shimniok/eeZeeAmp/README.md

eeZeeAmp is a breakout board for a standard LM386 audio amplifier circuit making it convenient to add audio
amplification to your breadboard projects.
