shimniok/eeZeeAmp/electronics/eeZeeAmp.brd

## EAGLE design electronics/eeZeeAmp.brd (2015-09-28)

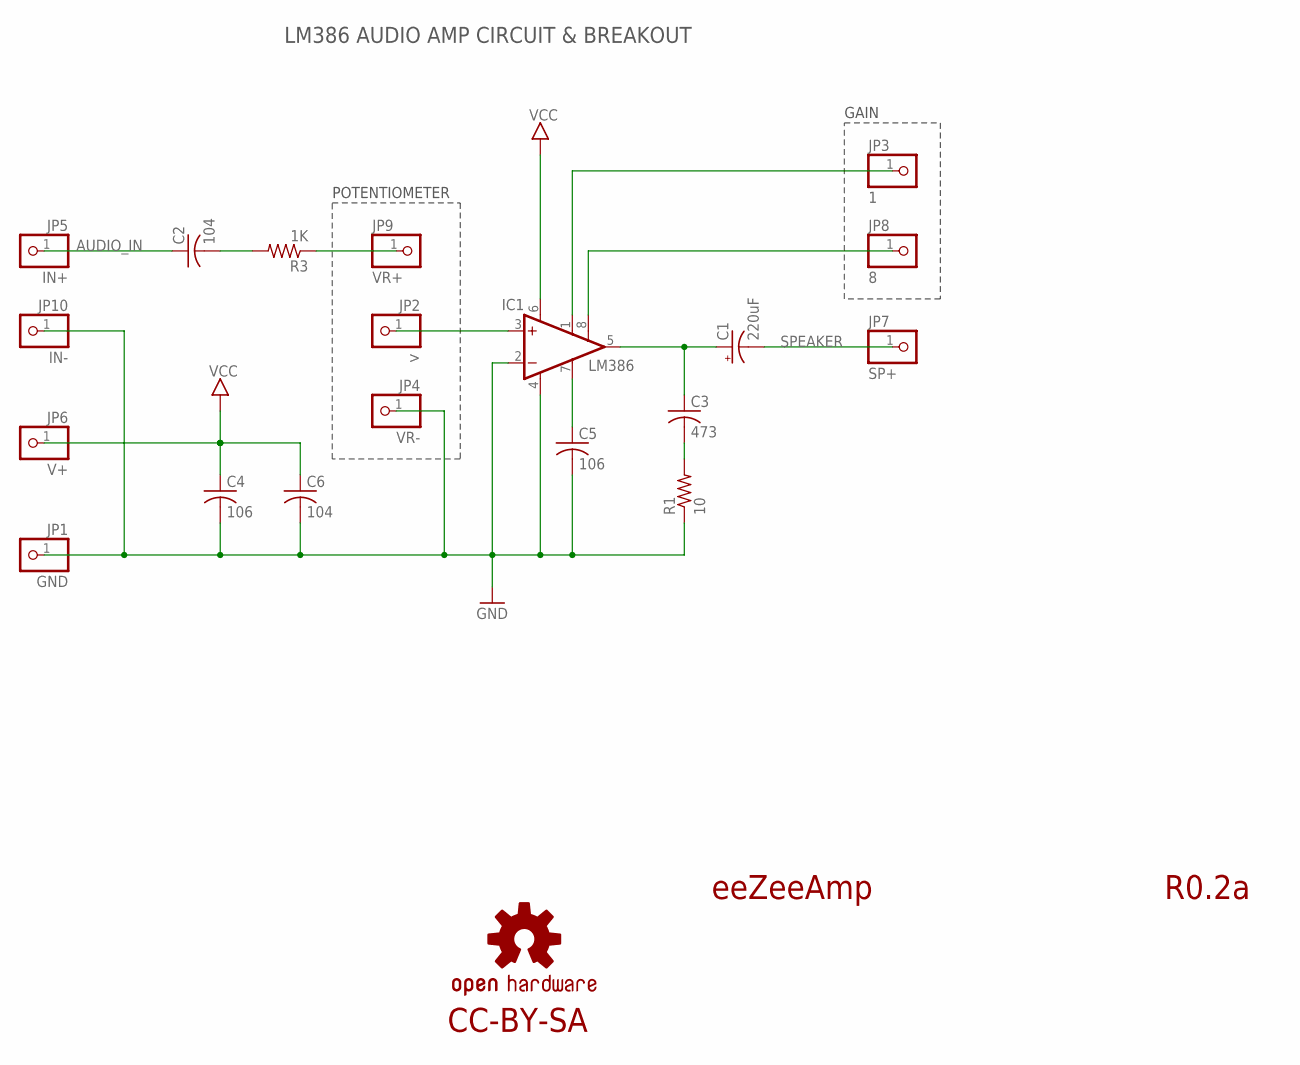
[picture p5: schematic eeZeeAmp.sch]

Parts:
C1: 220uF; E3,5-8
C2, C6: 104; C0603
C3: 473; C0603
C4, C5: 106; C1206
IC1: LM386; SO08
JP1: GND; 1X01-S
JP2: >; 1X01-S
JP3: 1; 1X01-S
JP4: VR-; 1X01-S
JP5: IN+; 1X01-S
JP6: V+; 1X01-S
JP7: SP+; 1X01-S
JP8: 8; 1X01-S
JP9: VR+; 1X01-S
JP10: IN-; 1X01-S
LOGO2: OSHW-LOGOS; OSHW-LOGO-S
R1: 10; R0603
R3: 1K; R0603

Connections:
1: IC1.1 (GAIN), JP3.1
3: IC1.3 (+IN), JP2.1
5: C1.+, C3.1, IC1.5 (OUT)
7: C5.1, IC1.7 (BYPASS)
8: IC1.8 (GAIN), JP8.1
AUDIO_IN: C2.1, JP5.1
GND: C4.2, C5.2, C6.2, IC1.2 (-IN), IC1.4 (GND), JP1.1, JP4.1, JP10.1, R1.1
unnamed: C2.2, R3.2
unnamed: C3.2, R1.2
unnamed: JP9.1, R3.1
SPEAKER: C1.-, JP7.1
VCC: C4.1, C6.1, IC1.6 (VS), JP6.1

Notes on the sheet:
eeZeeAmp
R0.2a
POTENTIOMETER
LM386 AUDIO AMP CIRCUIT & BREAKOUT
GAIN
CC-BY-SA

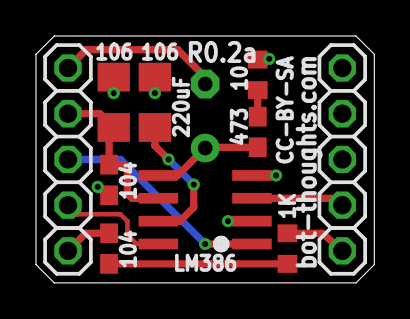
[picture p6: board eeZeeAmp.brd from above]

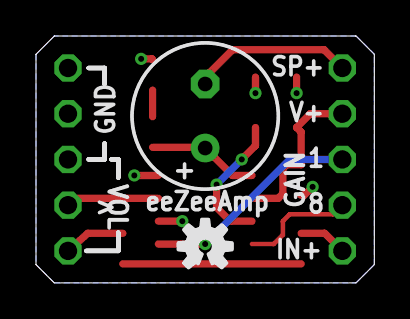
[picture p7: board eeZeeAmp.brd from below]

Board: 2 copper layers, 18.8 x 13.7 mm, 20 parts (2 on the bottom side), 12 nets.
