shimniok/eeZeeAmp/test/eeZeeAmpJig.brd

## EAGLE design test/eeZeeAmpJig.brd (2015-10-22)

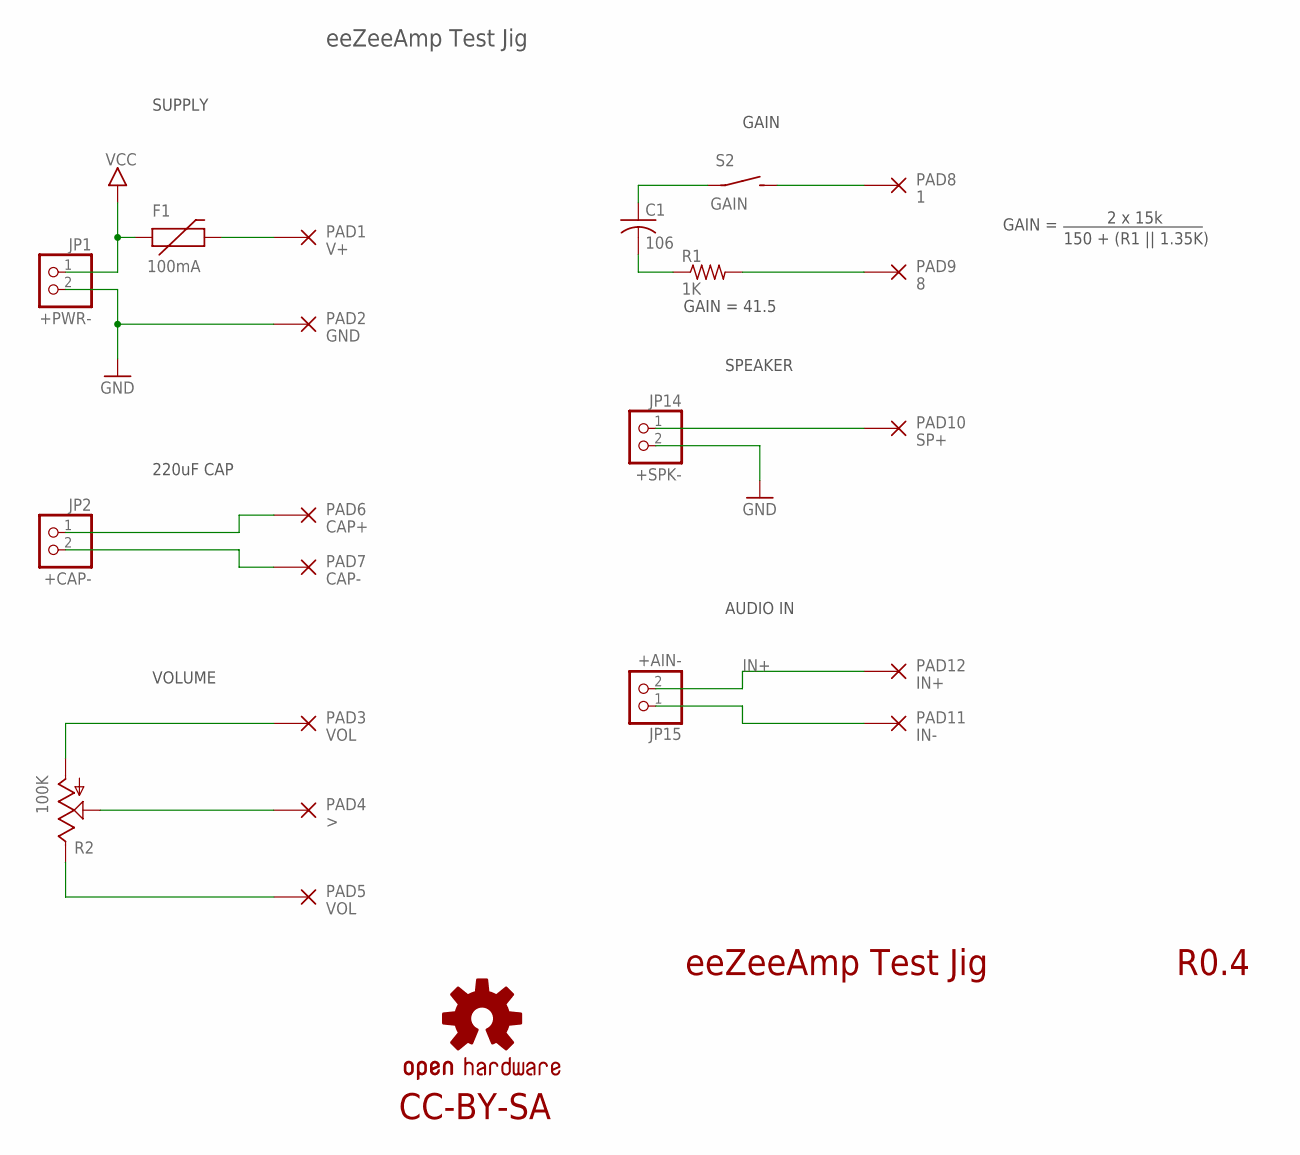
[picture p8: schematic eeZeeAmpJig.sch]

Parts:
C1: 106; C0805
F1: 100mA; 0603
JP1: +PWR-; 1X02-S
JP2: +CAP-; 1X02-S
JP14: +SPK-; 1X02-S
JP15: +AIN-; 1X02-S
LOGO2: OSHW-LOGOS; OSHW-LOGO-S
PAD1: V+; POGO_1.02MM
PAD2: GND; POGO_1.02MM
PAD3, PAD5: VOL; POGO_1.02MM
PAD4: >; POGO_1.02MM
PAD6: CAP+; POGO_1.02MM
PAD7: CAP-; POGO_1.02MM
PAD8: 1; POGO_1.02MM
PAD9: 8; POGO_1.02MM
PAD10: SP+; POGO_1.02MM
PAD11: IN-; POGO_1.02MM
PAD12: IN+; POGO_1.02MM
R1: 1K; R0603
R2: 100K; CA6H
S2: GAIN; 3X4X2TACT

Connections:
1: C1.1, S2.P$1
3: PAD4.P$1, R2.S
8: PAD9.P$1, R1.2
GND: JP1.2, JP14.2, PAD2.P$1
IN+: JP15.2, PAD12.P$1
IN-: JP15.1, PAD11.P$1
unnamed: PAD8.P$1, S2.P$2 (S)
unnamed: JP2.1, PAD6.P$1
unnamed: PAD5.P$1, R2.E
unnamed: F1.2, PAD1.P$1
unnamed: C1.2, R1.1
unnamed: JP2.2, PAD7.P$1
unnamed: PAD3.P$1, R2.A
SPEAKER: JP14.1, PAD10.P$1
VCC: F1.1, JP1.1

Notes on the sheet:
eeZeeAmp Test Jig
R0.4
GAIN
CC-BY-SA
VOLUME
SUPPLY
AUDIO IN
SPEAKER
GAIN =
2 x 15k
150 + (R1 || 1.35K)
GAIN = 41.5
220uF CAP

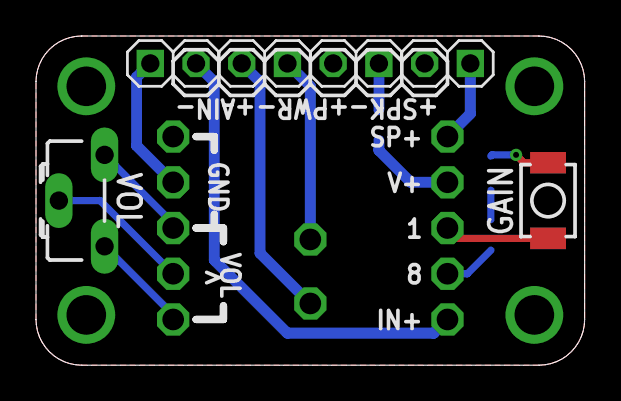
[picture p9: board eeZeeAmpJig.brd from above]

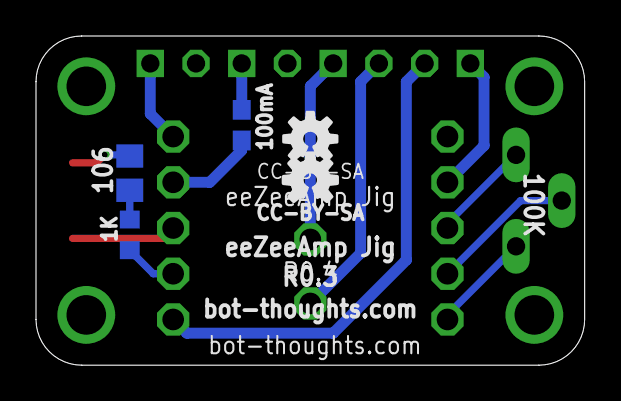
[picture p10: board eeZeeAmpJig.brd from below]

Board: 2 copper layers, 30.5 x 18.3 mm, 22 parts (4 on the bottom side), 15 nets.
