shimniok/eeZeeAmp/(commit log)

2014-12-01 Initial revision
    [eeZeeAmp.brd, eeZeeAmp.sch]
2014-12-01 Minor updates, added gerbers, zip
    [eeZeeAmp.brd, eeZeeAmp.sch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]
2015-01-02 Final version of silk
    [eeZeeAmp.brd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]
2015-01-02 Fixed silk pin 1 on LM386, updated version #
    [eeZeeAmp.brd, eeZeeAmp.sch]
2015-05-01 Added 0.1uF decoupling cap for LM386 supply
    [eeZeeAmp.sch]
2015-05-01 Replaced offboard pot with pin header for clarity
    [eeZeeAmp.sch]
2015-05-01 Revised pinout with single ground in attempt to remove ground loop. Revised schematic to use individual pin headers
    [eeZeeAmp.sch]
2015-05-01 Separated gain pin header into individual pins
    [eeZeeAmp.sch]
2015-05-01 Separated variable resistor header into individual pins
    [eeZeeAmp.sch]
2015-05-01 Aesthetic mod
    [eeZeeAmp.sch]
2015-05-01 Added another ground pin, rearrange layout
    [eeZeeAmp.sch]
2015-05-01 Narrowed by 0.1", complete redo of layout, text, accommodated larger 8mm output cap, fitted decoupling 0.1uF, located all gnd near to avoid loop, removed top ground pour
    [eeZeeAmp.brd]
2015-05-01 moved label
    [eeZeeAmp.sch]
2015-05-01 Added title, OSHW logo on both sheets, relabeled gnd, audio in gnd pin header, added gain label, added cc
    [eeZeeAmp.brd, eeZeeAmp.sch]
2015-05-03 Created silk and gerbers
    [eeZeeAmp.brd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]
2015-09-28 Changed 503 cap to more common value 473
    [eeZeeAmp.brd, eeZeeAmp.sch]
2015-09-30 Added assembly instructions
2015-10-01 Added test jig
    [eeZeeAmpJig.brd, eeZeeAmpJig.sch]
2015-10-01 Altered gain to 40.5 with resistor, changed pot value, created silk and gerbers
    [eeZeeAmpJig.brd, eeZeeAmpJig.sch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]
2015-10-01 created zip of jig gerbers
2015-10-01 increased switch/pot clearance by embiggening board. Moved fuse to bottom layer. Changed some silk
    [eeZeeAmpJig.brd]
2015-10-01 Updated gerbers
    [eeZeeAmpJig.drills.xln]
2015-10-06 Added test jig schematic
    [eeZeeAmpJig.sch]
2015-10-06 Added LM386 Calculator spreadsheet
    [LM386_Calculator.ods]
2015-10-22 increased drill size for pogos, replaced microB with pin headers, moved power, ain, spkr pin headers, shrank board, centered pogo pin test area, reduced mounting hole drill size to #2, reduced spacer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
    [eeZeeAmpJig.brd, eeZeeAmpJig.sch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]
2015-10-22 Moved Jig files into subdirectory
    [eeZeeAmpJig.brd, eeZeeAmpJig.sch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]
2015-10-22 added pogo pins for output audio cap
    [eeZeeAmpJig.brd, eeZeeAmpJig.sch]
2015-10-22 Fixed capacitor labels, polarity
    [eeZeeAmpJig.brd]
2015-10-23 moved electronics into subdirectory
    [eeZeeAmp.brd, eeZeeAmp.sch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]
